vincentgosselin1/Arduino_node/README.md

# This is the BELIOT project
This is an Internet Of Things project.
This project contains an Arduino Nano which is the core microcontroller of module.
The module contains an RF circuit (inAir9B) with LoRaWAN technology. This node sends
data to a Raspberry Pi via RF and the Raspberry Pi posts its data to a Webserver via a Ruby script.
Webserver (Ruby on Rails app) can be reach at beliotv3.herokuapp.com . Data is stored into InfluxDB and data
can be visualized with Grafana.

This unit monitores : 
- soil humidity/temperature
- air humidity/temperature
- Ozone concentration
- Dust concentration
- GPS
- Battery Life

Here is a picture of the Arduino node:
beliot_pic

Here is the circuitry inside the Stevenson Cage:
the_whole_thing

Here is the Raspberry Pi Gateway to receive/send data:
raspgithub

Here is a picture of successfull tranmission from Arduino node to Raspberry Pi (seen on rasp console):
successfull_com

Here is the landing page of the website:


Here is some data plotted using Grafana:
some_data

The PCBs and electronics circuits were made using the KiCad software.

A User Manual (in French) is to be found on PDF.
