vincentgosselin1/Arduino_node/user_manual/Manuel_de_lutilisateur_v1.pdf

# Manuel de l’utilisateur v1

Noeud + Passerelle LoRa, Projet Beliot

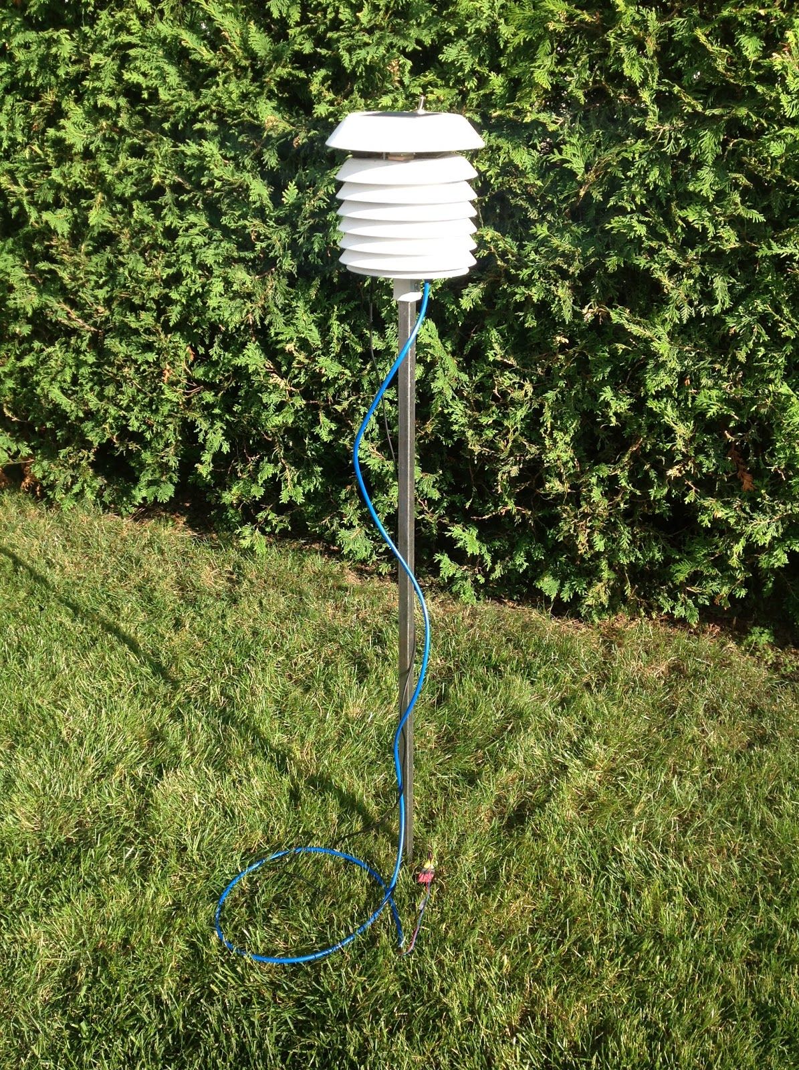
[picture p1: figure]

Par
Vincent Gosselin

Fait le 8 Août 2017

# Table des matières

Installation de la passerelle | p.3-5
Installation du noeud | p.5-6
La Plateforme Web | p.7
Où trouver le travail réalisé | p.7
Considérations importantes | p.8

# Installation de la passerelle

1. Brancher le Raspberry Pi dans un routeur à l’aide d’un cable Ethernet.
2. Brancher l’alimentation du Raspberry Pi.
3. Mettre le Raspberry PI a “ON’’ (alimenter)
4. Découvrir et noter le IP local du Raspberry PI à l’aide de la page web du routeur. Chez moi, le routeur à l’adresse ‘’http//home/”.
5. À l’aide de la console tapez :
‘’ssh pi@XXX.XXX.XXX.XXX’’
où XXX.XXX.XXX.XXX correspond au IP découvert à l’étape 4.
6. Le mot de passe est :
‘’raspberry’’
7. Une fois entrer dans le raspberry pi, tapez la commande : ‘’tmux ls’’.
La commande va retourner un message d’erreur si il n’y a pas de session tmux déjà lancé:

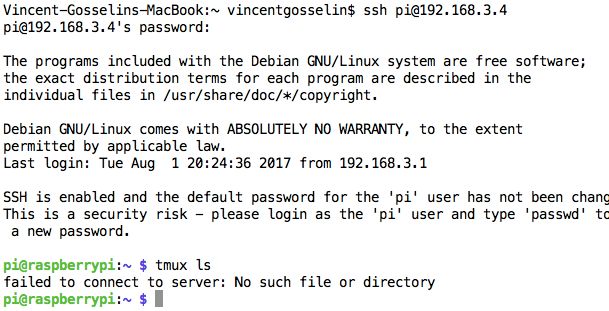
[picture p2: figure]

Si il y avait un serveur tmux de disponible, il suffit de tapper “tmux attach’’ pour se connecter à la session tmux.

8. Tapez la commande ‘’tmux’’ pour démarrer une nouvelle session tmux.
Une fois la session tmux lancé, une barre verte apparait en bas d’écran.

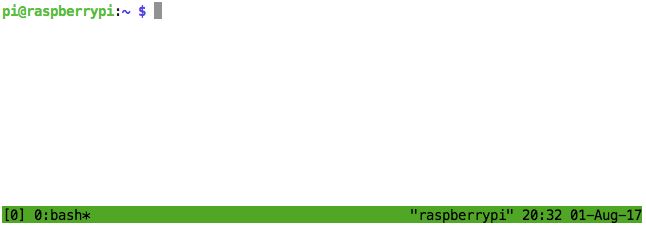
[picture p3: figure]

9. Entrer la commande ‘’cd /home/pi/Desktop/LowCostLoRaGw/lora_gateway’’ pour accéder au répertoire de la passerelle LoRa.

10. Taper ‘’ls’’ pour voir le contenu du dossier.
À titre d’information :
- Le script STARTGATEWAY.sh sert à activer la passerelle.
- Le fichier lora_gateway.cpp sert à la configuration de la bande de fréquence du module LoRa. En Amérique, il s’agit de la bande 915 MHz. En Europe, il s’agit de la bande de 868 MHz. Après chaque modification de lora_gateway.cpp, il faut recompiler avec la commande ‘’make lora_gateway_pi2’’. Le raspberry pi a déjà été configuré en 868MHz.
- Le fichier post_to_influxdb_v3.rb sert à envoyer les données reçues de la passerelle vers la plateforme Web. Ce fichier a été placé dans clouds.json pour être appellé via le script post_processing_gw.py

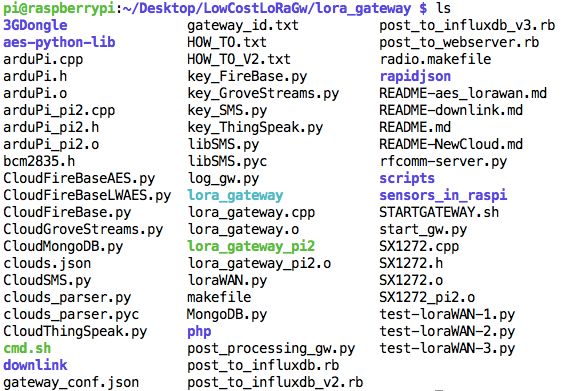
[picture p4: figure]
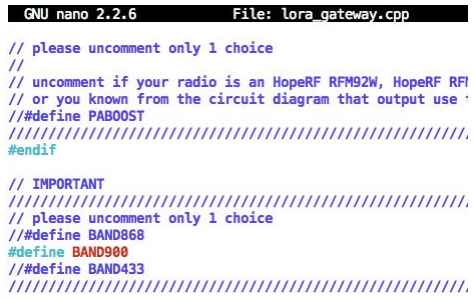
[picture p5: figure]

11. Taper ‘’bash STARTGATEWAY.sh’’ pour activer la passerelle. L’écran devrait alors avoir l’allure suivante :

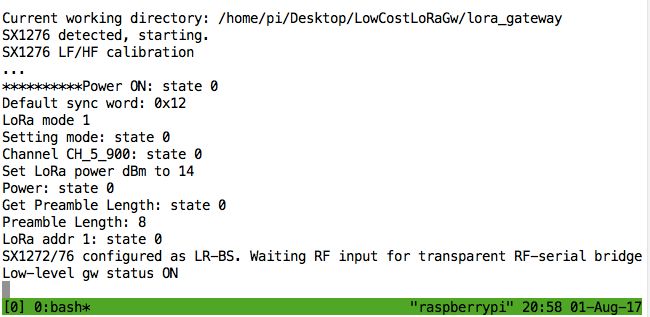
[picture p6: figure]

12. Enfoncer (CTRL+B), Relacher et appuyer sur D pour se déttacher de la session tmux.

13. Taper ‘’exit’’ pour se déconnecter du raspberry pi.

La passerelle est maintenant configuré.

# Installation de noeud

1. Planter la barre dans le sol a l’aide d’un maillet.
2. Installer la tête du prototype sur la barre de fer et visser la tête sur la barre de fer.

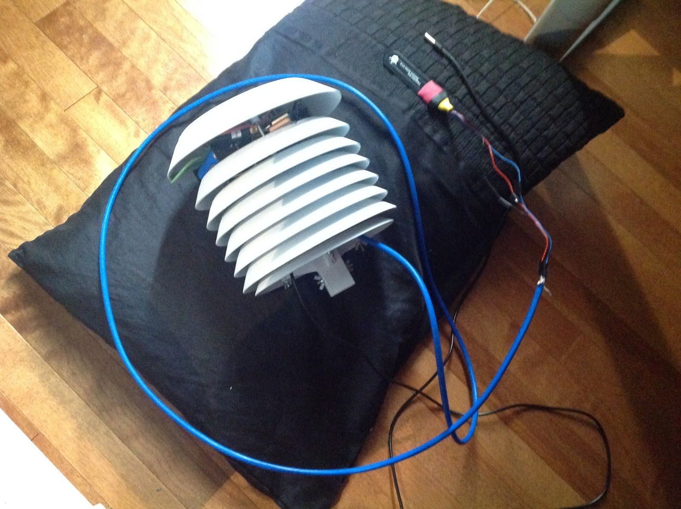
[picture p7: figure]

3. Activer la SWITCH à ON sur la tête du prototype pour mettre le noeud en mode actif.

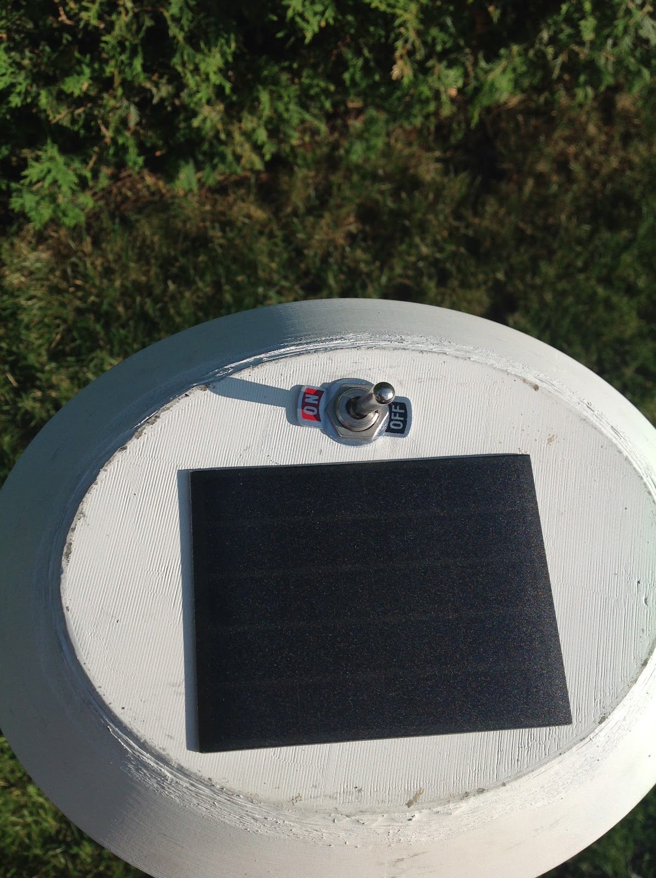
[picture p8: figure]

4. Après 40 secondes, un message sera reçu sur le rasp dans la session tmux pour indiquer une communication réussi.

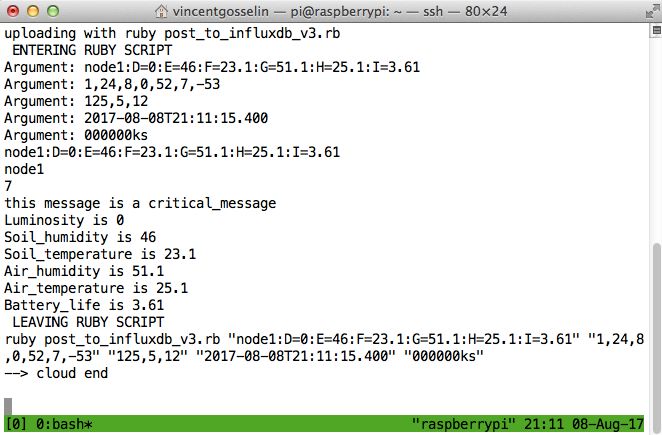
[picture p9: figure]

6. Planter dans le sol la sonde de température et la sonde d’humiditié.
7. En cas, d’échec de cette réception de donnée, Switch -> OFF, Switch -> ON, devrait réussir la communication. Parfois (rarement), il y a une erreur LoRa pendant la première transmission. Donc, éteindre et ré-allumer le prototype devrait faire.
8. Noter qu’il serait important d’avoir un recouvrement de la tête sur la partie supérieure afin de protéger la partie électronique du contact de l’eau.
9. Pour programmer le arduino attaché au prototype, il est très important de mettre la SWITCH à OFF avant de connecter le port USB.

# La plateforme Web

1. La plateforme Web est accessible à l’adresse beliotv3.herokuapp.com
2. Pour avoir les prévisions locales, Cliquer sur l’image de la météo.
3. Pour l’historique du noeud, Cliquer sur l’image de Grafana.
4. Sur Grafana, Usager : ‘’client’’ Mot de passe : ‘’vignesbordeaux’’
5. Sélectionner le Dashboard ‘’vignes_bordeaux_v1’’

Pour l’info, le site web est contenu sur la plateforme Heroku et est codé en Ruby. Le code du site web est disponible sur Github : https://github.com/vincentgosselin1/beliotv3 . La base de données Influxdb + Grafana sont hébergé sur la plateforme de Amazon Web Services.

Notez que la gratuité de la plateforme Web sur Amazon Web Services prend fin Mai 2018, prière de communiqué vincentgosselin1@gmail.com avant la date d’échéance.

# Où trouver le travail réalisé

1. La totalité du travail se trouve à l’adresse : https://github.com/vincentgosselin1/Arduino_node
2. Le code principale qui doit être flashé dans le arduino nano se trouvre dans le dossier Main et se nomme ‘’main.cpp”. Afin de compiler le code dans le arduino, il est important de copier/coller la totalité du fichier main.cpp dans un fichier .ino pour flasher le arduino. En plus, il faut copier le contenu du dossier ‘’libraries’’ dans le répertoire des libraries Arduino. Sur mon Macbook, la location de ce dossier se trouve dans ‘’/Users/vincentgosselin/Documents/Arduino/libraries’’.
3. Les projets Kicad pour les circuits électriques ainsi que les pcbs sont inclus dans le Github dans la section Electronics.

# Considération importantes

1. Le module consomme plus que prévue, un erreur au niveau de la conception électrique sur un régulateur force la consommation à 150mA en mode actif et à 60mA en mode économie d’énergie. La faute est à cause de la ligne 5V qui ne va pas à 0V quand le régulateur ‘’shut-off’’. En enlevant le GPS + Détecteur de poussière, la consommation passe à 40mA en mode actif et 10mA en mode économie d’énergie. Pour une raison qu’on ignore encore, le mode économie d’énergie observer sur plaque d’essais, ne descend pas jusqu’à 0.25mA. Ceci est à investiguer.
2. Il faut recouvrir la partie suppérieure de la tête du prototype pour le rendre imperméable à l’eau (la partie inférieur l’est). Du simple “Duck tape’’ fait l’affaire.
3. Un optimisation de code a été fait mais elle s’est avéré inéfficace puisque le programme atteignait 98% de mémoire statique et 80% mémoire dynamique avec l’inclusion du capteur de luminosité. La communication LoRa ne fonctionnait pas et un message de ‘’warning’’ sur Arduino apparaissait. Alors, c’est pour cette raison que le capteur de luminosité ne fait pas partie du prototype. Le code est stable maintenant.
