vincentgosselin1/Arduino_node/code_arduino_nano/arduino_nano_dht11_v2/arduino_nano_dht11_v2.cpp

#include <arduinonanodht11.h>

//MAIN

//arduino_nano_dht11_v2
//With custom library

//By Vincent Gosselin, 2017.

dht11 dht11(2);//PIN 2.


void setup() {
  // put your setup code here, to run once:
  Serial.begin(38400);
  Serial.println("Hello");
  
  
}

void loop() {
  // put your main code here, to run repeatedly:
  delay(1000);
  dht11.scan();
  delay(1000);
  Serial.print("Humidity is : ");Serial.println(dht11.get_humidity(),DEC);
  Serial.print("Temperature is : ");Serial.println(dht11.get_temperature(),DEC);
}
