vincentgosselin1/Arduino_node/(commit log)

2017-06-23 with Arduino_tools of course
2017-06-23 now with Dth11 sensor
2017-07-02 Soil Temperature done, O3_sensor coming...
2017-07-08 7mA current consumption min
2017-07-12 now with dust sensor, lots of tweaks were needed
2017-07-12 Dust sensor working (lots of tweaks were needed)
2017-07-14 For MQ7 sensor, fil rouge (pin 2) -> D5, fil bleu (pin 3) -> A2
2017-07-16 new lib with reduced footprint, need to clean the main and make library for NEW low-power
2017-07-17 all sensors on grafana
2017-07-29 LUX and CO de-activated, 40sec for GPS wakeup
2017-07-29 now 2 diffferent timers to send LoRa, GPS is now CI = lat, CII = lon
2017-07-29 critical sensors every 10min, non-critical every hour. Need to seed to confirm accuracy overtime
2017-08-06 now with battery voltage
2017-08-08 now with POWER and SENSOR UNIT
